saisaokh/cse453/IMG_20170519_164301.jpg

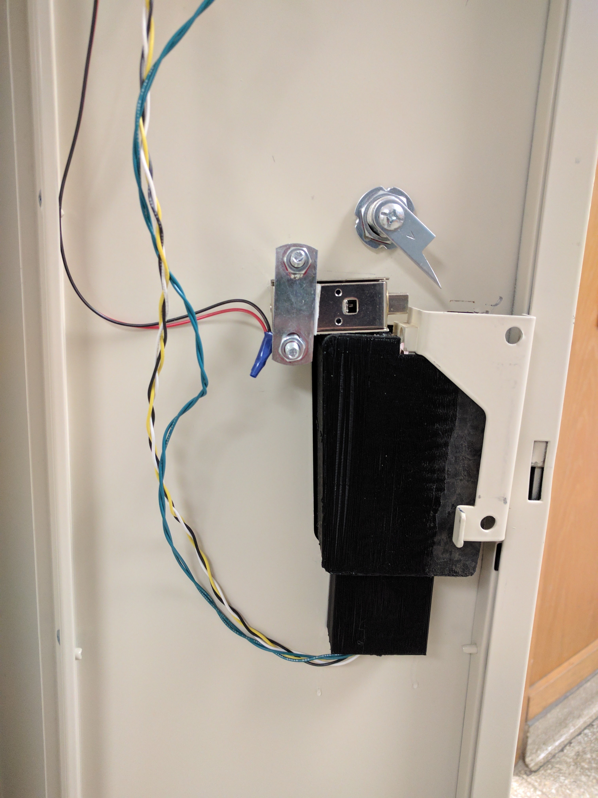
IMG_20170519_164301.jpg
