saisaokh/cse453/IMG_8142.JPG

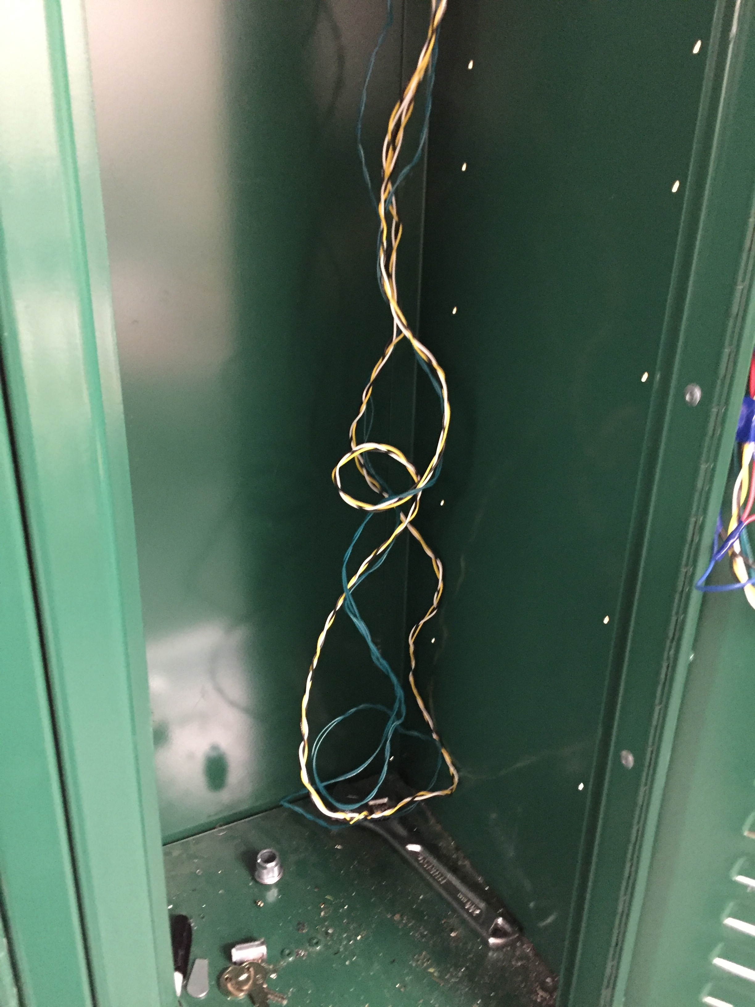
IMG_8142.JPG
