saisaokh/cse453/README.md

Final Presentation.pdf conclude overall.
