saisaokh/cse453/ProgressReport221-35.docx

Accomplished:

- Received the lockers and moved them into the baldy lab
- Placed order for most parts we will need for the project
- Discussed how we will modify the locker to use the solenoid that we ordered.

Upcoming:

- When parts come in we will finalize how the locking mechanism is going to work.
- Need to start testing the arduino with the screen for power consumption metrics.
- Test the solar panel to see how much power output it will offer us.
