saisaokh/cse453/FinalPresentation.pdf

‘-

1

Alden School District

# Automated Locker

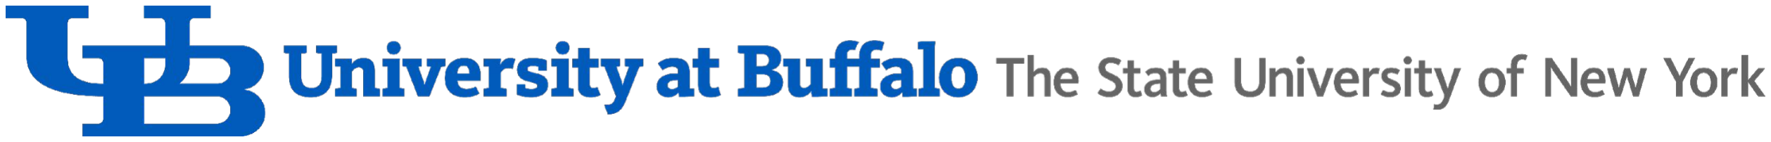
[picture p12: figure]

‘-

2

Mark Grassi
Sanjeevani Choudhery
John Fincken
Tristan Syre
Alex Kirschner
John McKissick
Sai Kham
Drew Clark

### Team Members

‘-

3

- Some students at Alden high school have difficulty opening lockers with a regular combination lock.
- The locks are too small and complicated for some students to use.
- The school wants an easier way for these students to open their lockers while still using a passcode.

### The Problem

‘-

4

### Approach

- Battery powered touch screen system to control solenoid lock
- Screen’s embedded microprocessor will be used to check user input and signal solenoid
- Custom 3-D printed case to mount screen in locker recess

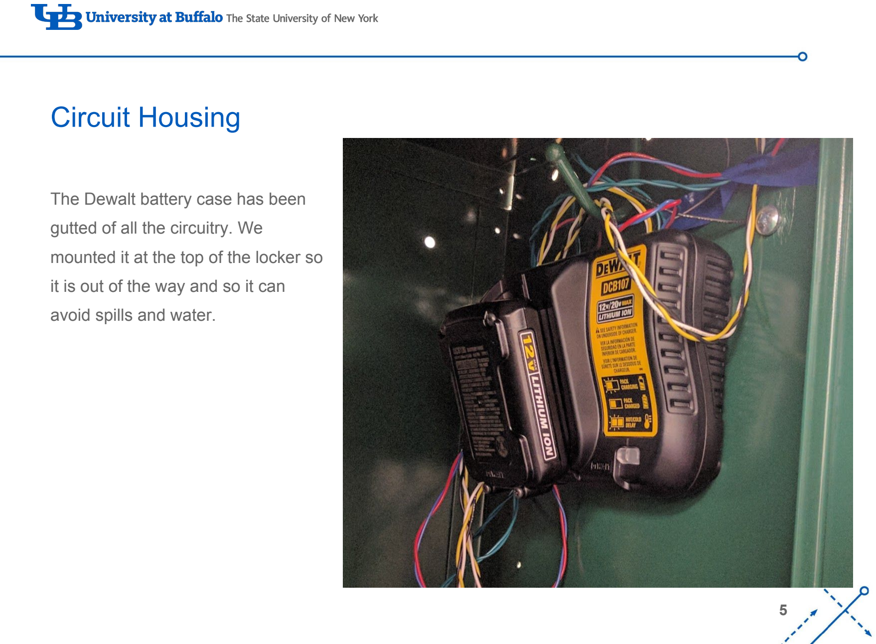
[picture p13: page 5]

‘-

5

The Dewalt battery case has been

gutted of all the circuitry. We

mounted it at the top of the locker so

it is out of the way and so it can

avoid spills and water.

### Circuit Housing

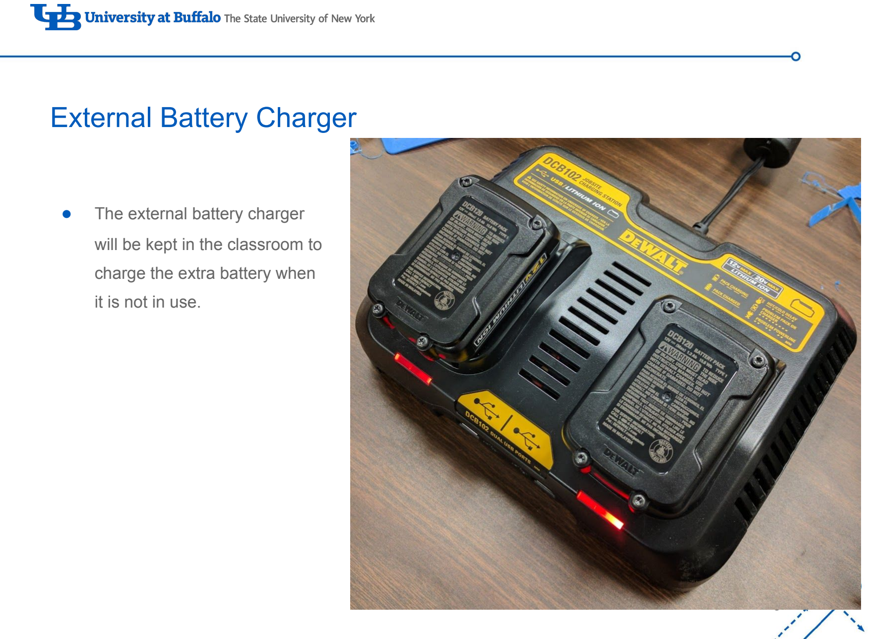
[picture p14: page 6]

‘-

6

- The external battery charger

will be kept in the classroom to

charge the extra battery when

it is not in use.

### External Battery Charger

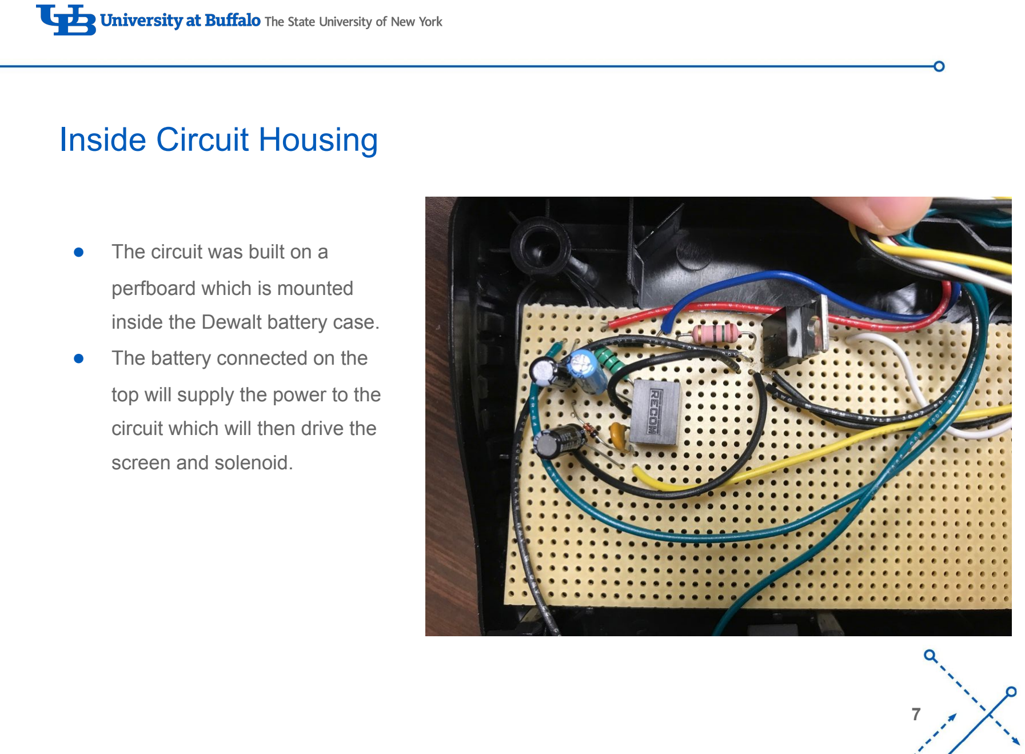
[picture p15: page 7]

‘-

7

- The circuit was built on a

perfboard which is mounted

inside the Dewalt battery case.

- The battery connected on the

top will supply the power to the

circuit which will then drive the

screen and solenoid.

### Inside Circuit Housing

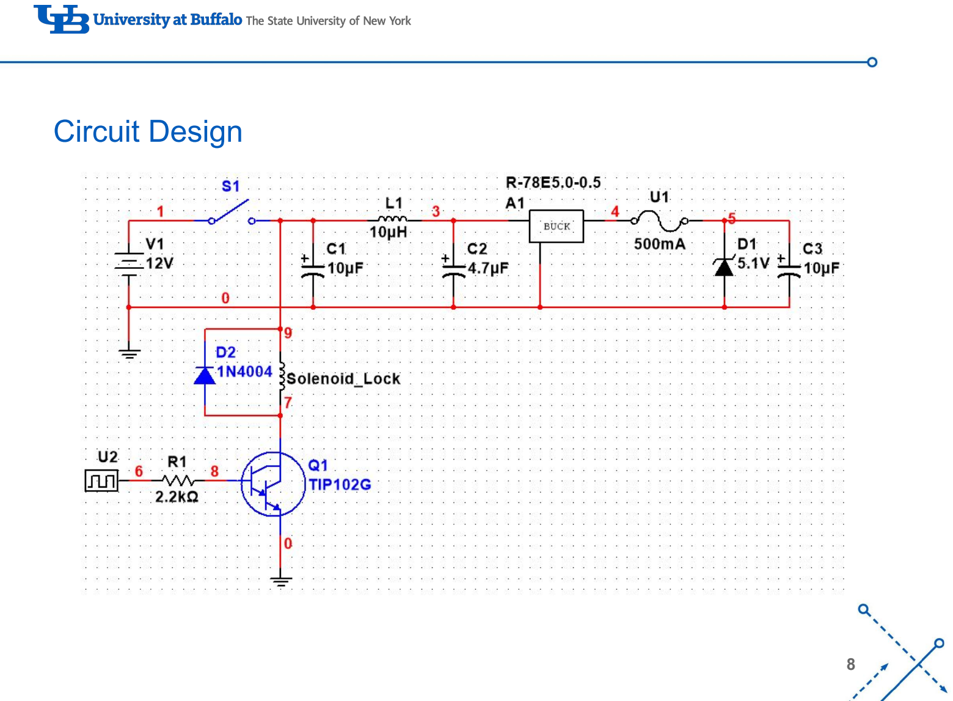
[picture p16: page 8]

‘-

8

### Circuit Design

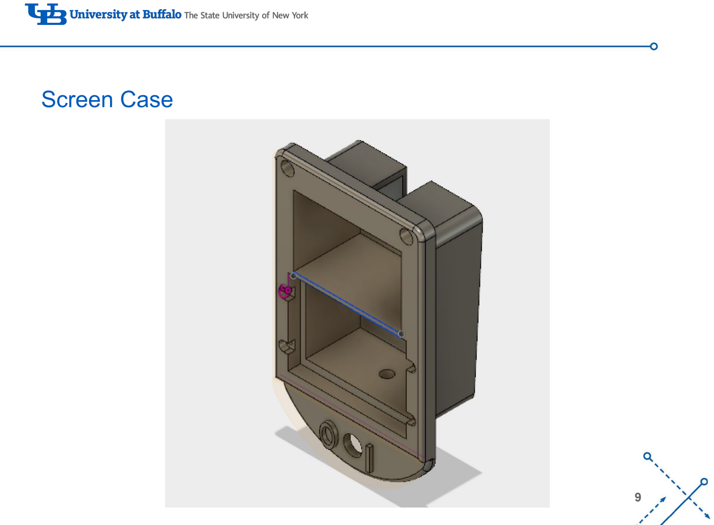
[picture p17: page 9]

‘-

9

### Screen Case

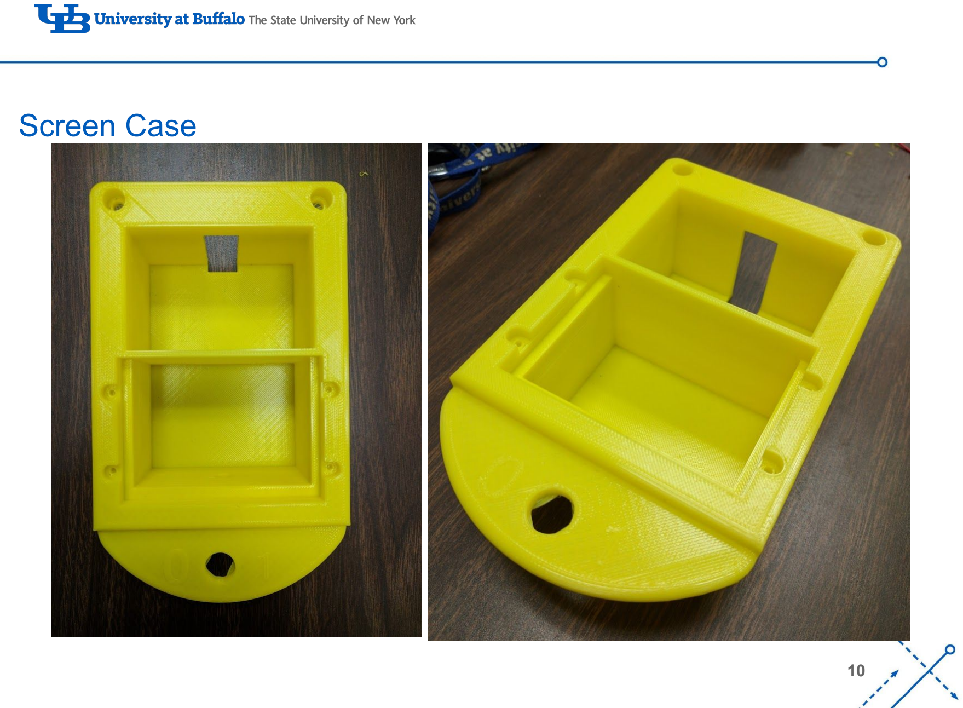
[picture p18: page 10]

‘-

10

### Screen Case

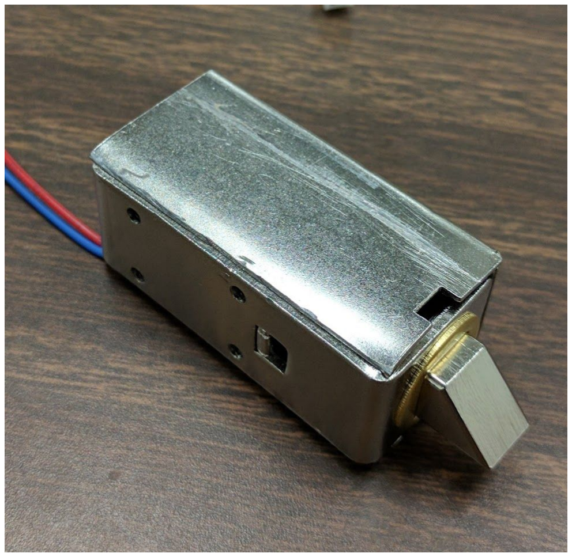
[picture p19: figure]

‘-

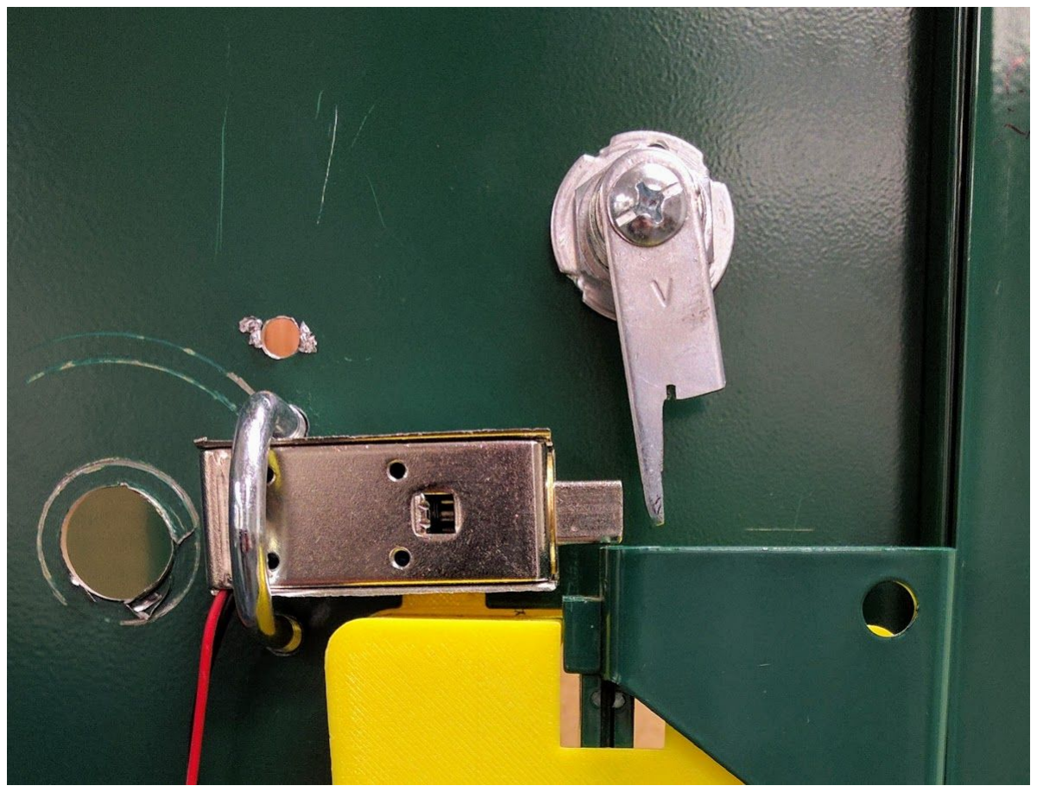
[picture p20: figure]

11

- The solenoid remains in the

locked position while no power is being supplied to it.
- When the user enters the

passcode the solenoid will open for 5 seconds allowing the user to lift the handle and open the locker.

### Solenoid

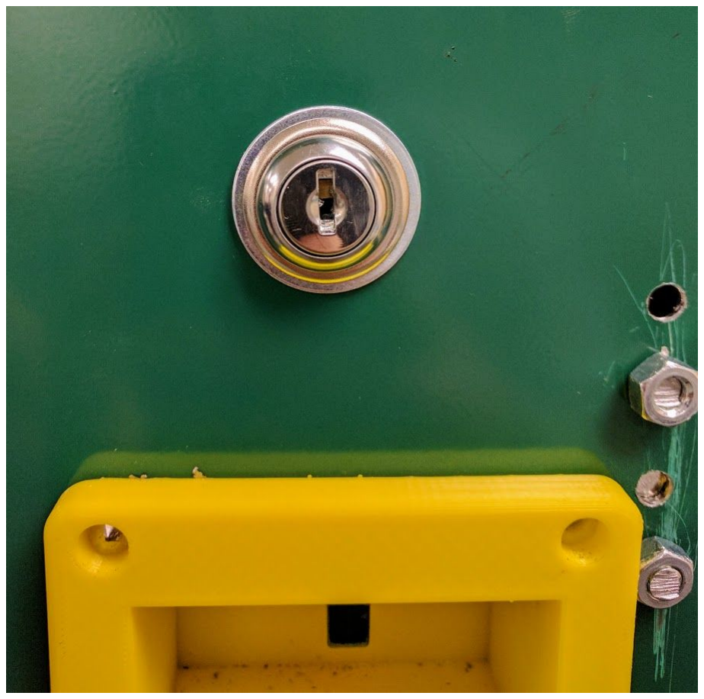
[picture p21: figure]

‘-

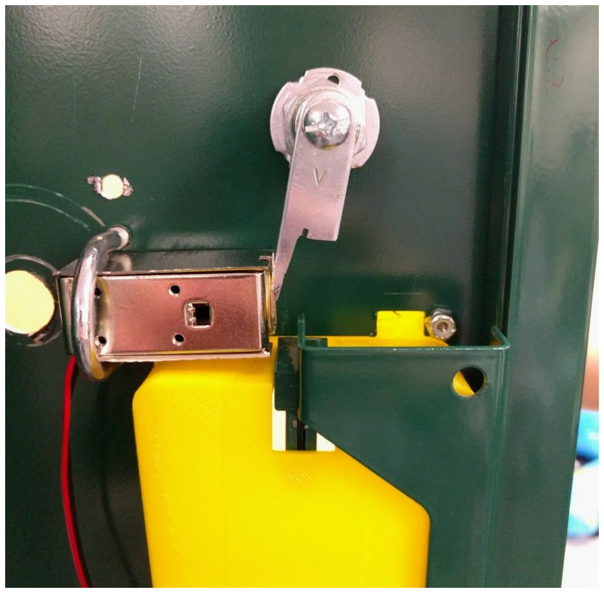
[picture p22: figure]

12

- The manual override is

used with a key we provide.
- A plate will push the

solenoid lock out of the way so the locker can be opened by faculty members or if the battery dies.

### Manual Override

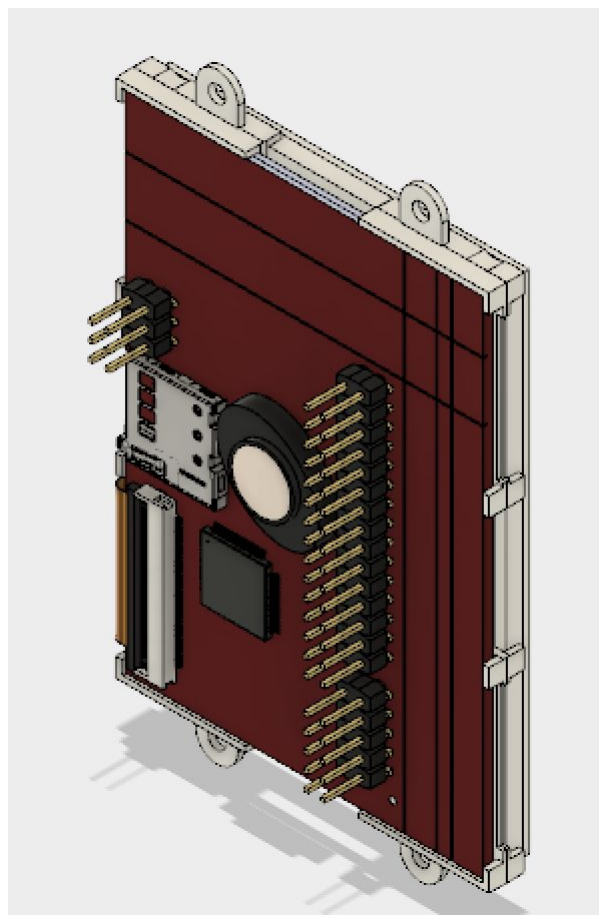
[picture p23: figure]
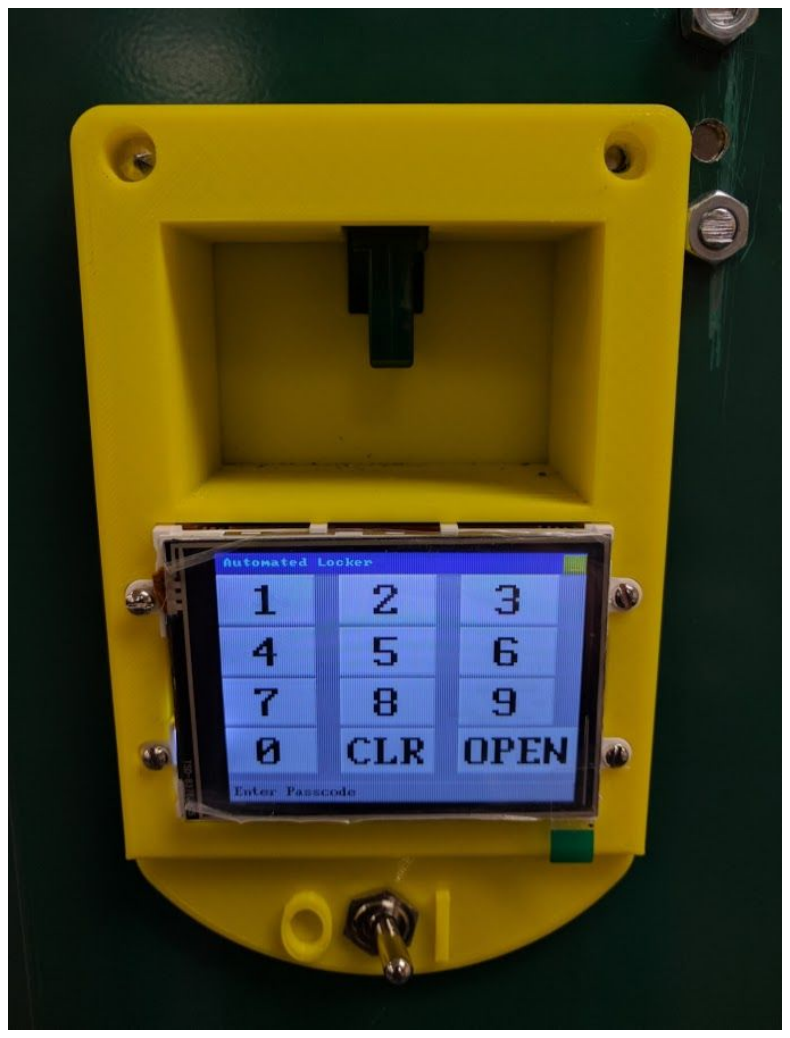
[picture p24: figure]

‘-

13

- Student User can

open
- Admin User can

reset password
- Powers off when not

in use

### Screen

14

### Locker Demo using the screen

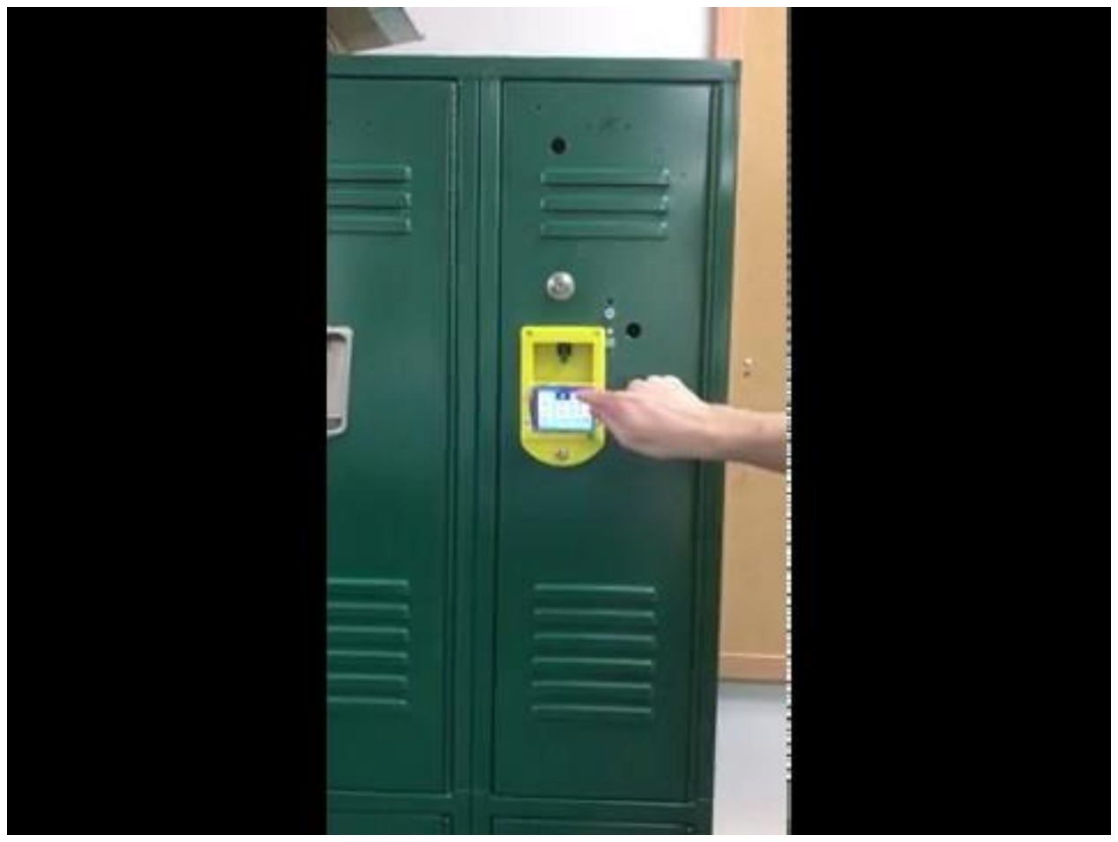
[picture p25: figure]

15

### Locker Demo with manual override

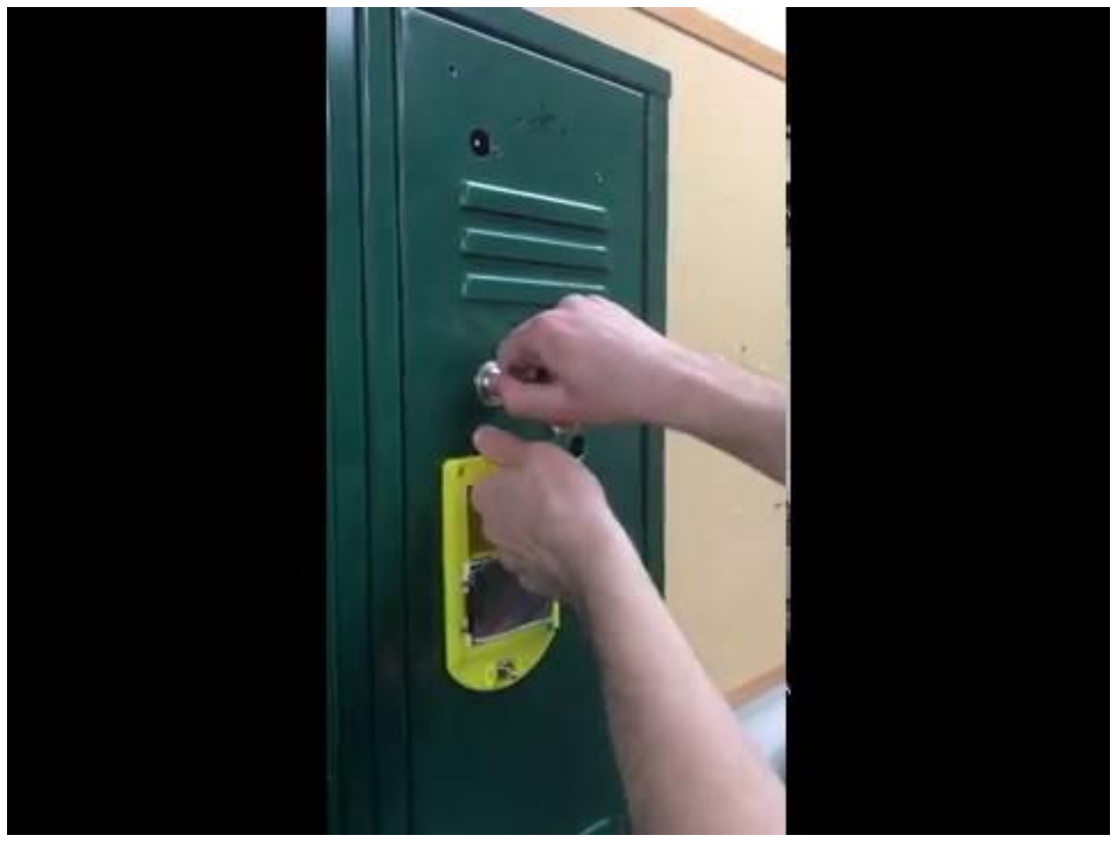
[picture p26: figure]
