saisaokh/cse453/IMG_8066.JPG

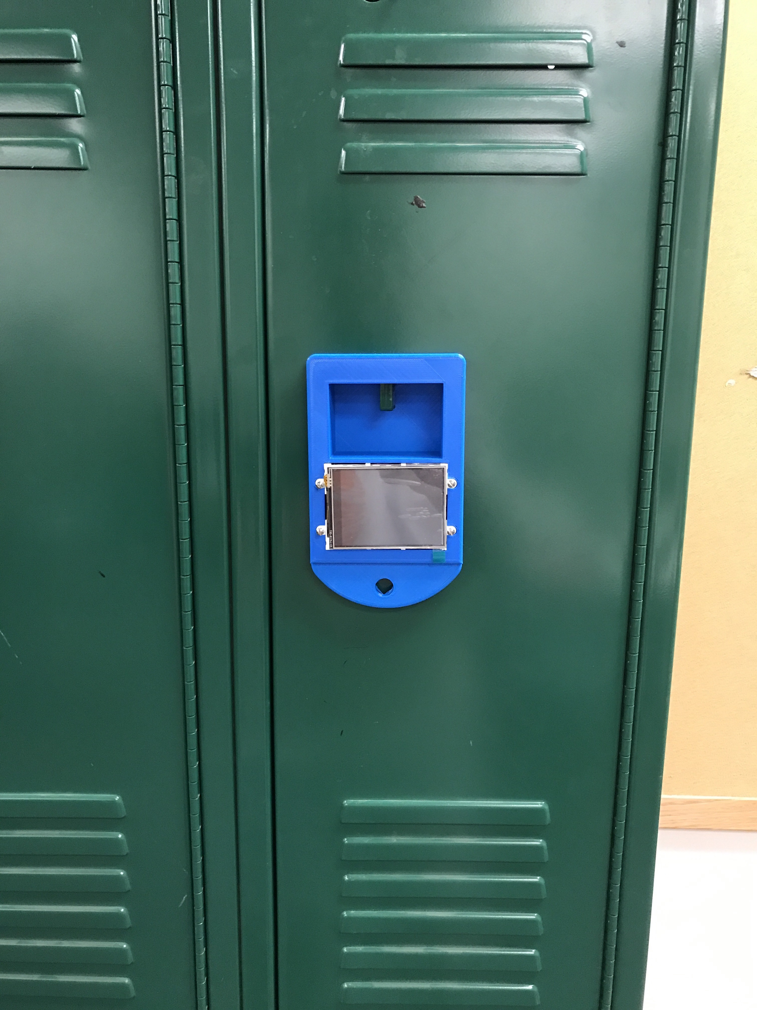
IMG_8066.JPG
