saisaokh/cse453/IMG_8068.JPG

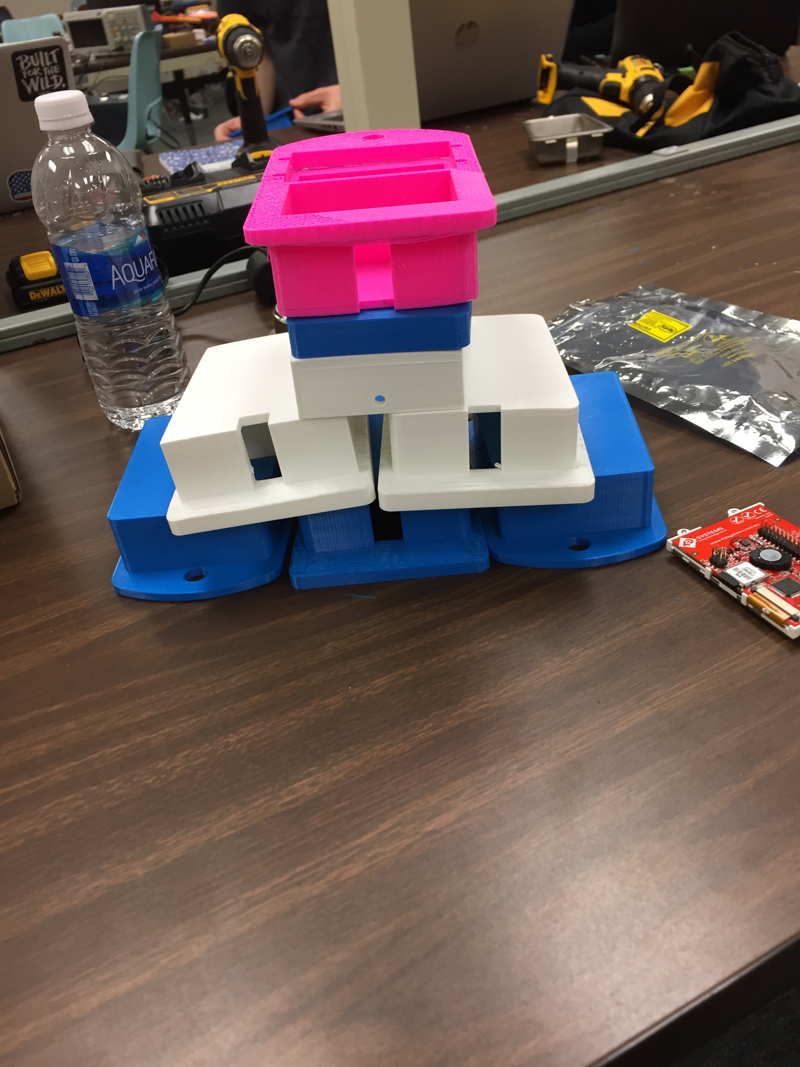
IMG_8068.JPG
