saisaokh/cse453/IMG_8139.JPG

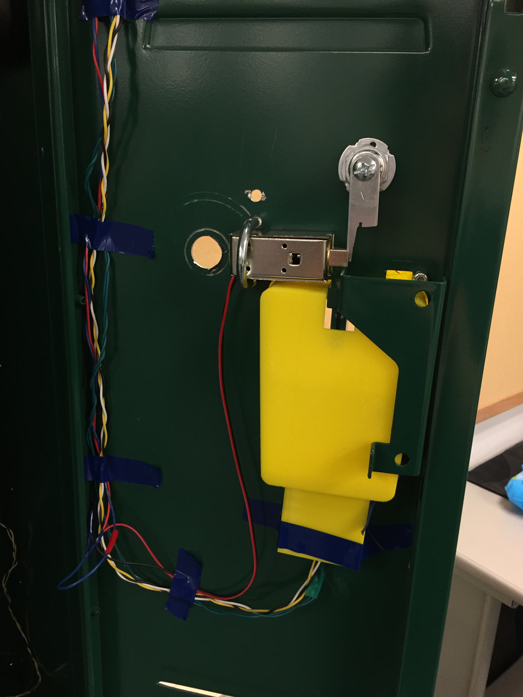
IMG_8139.JPG
