saisaokh/cse453/IMG_8140.JPG

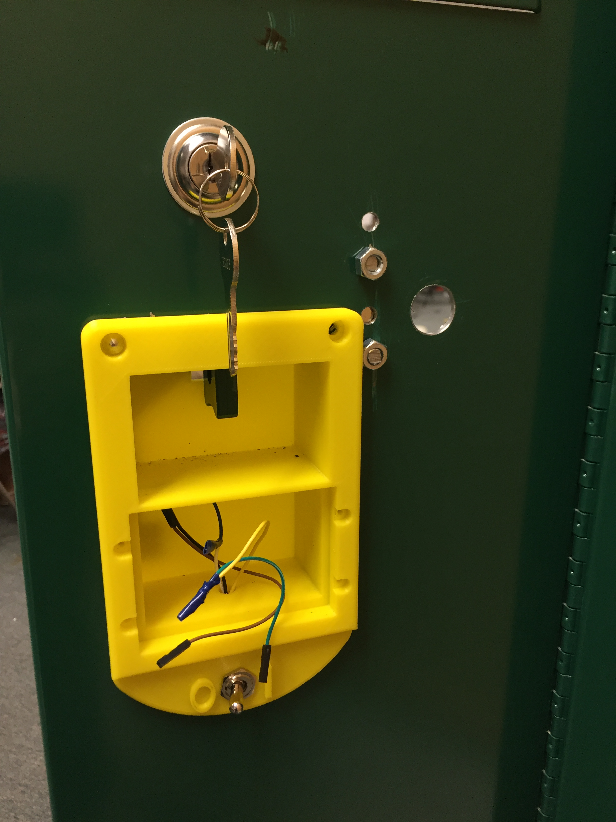
IMG_8140.JPG
