saisaokh/cse453/IMG_8141.JPG

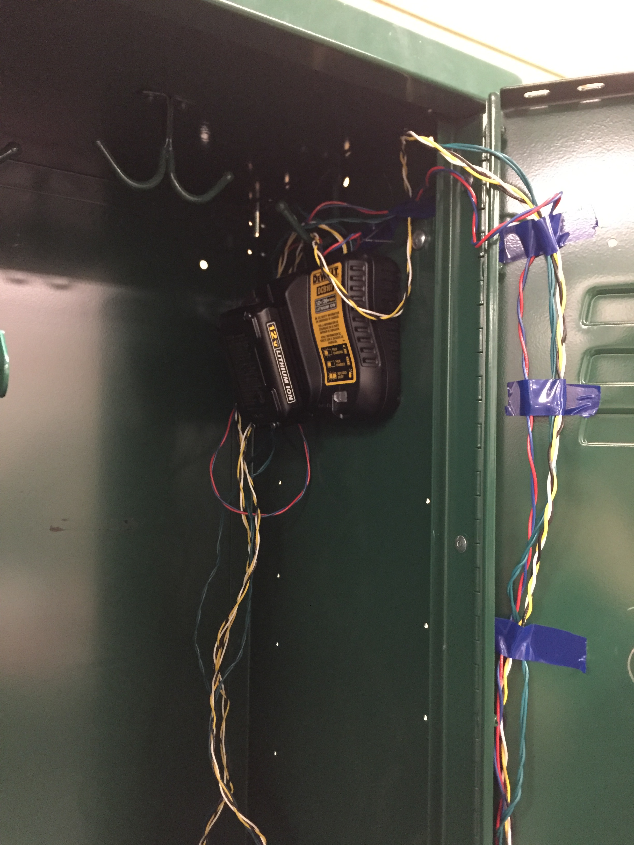
IMG_8141.JPG
