saisaokh/cse453/IMG_8166.PNG

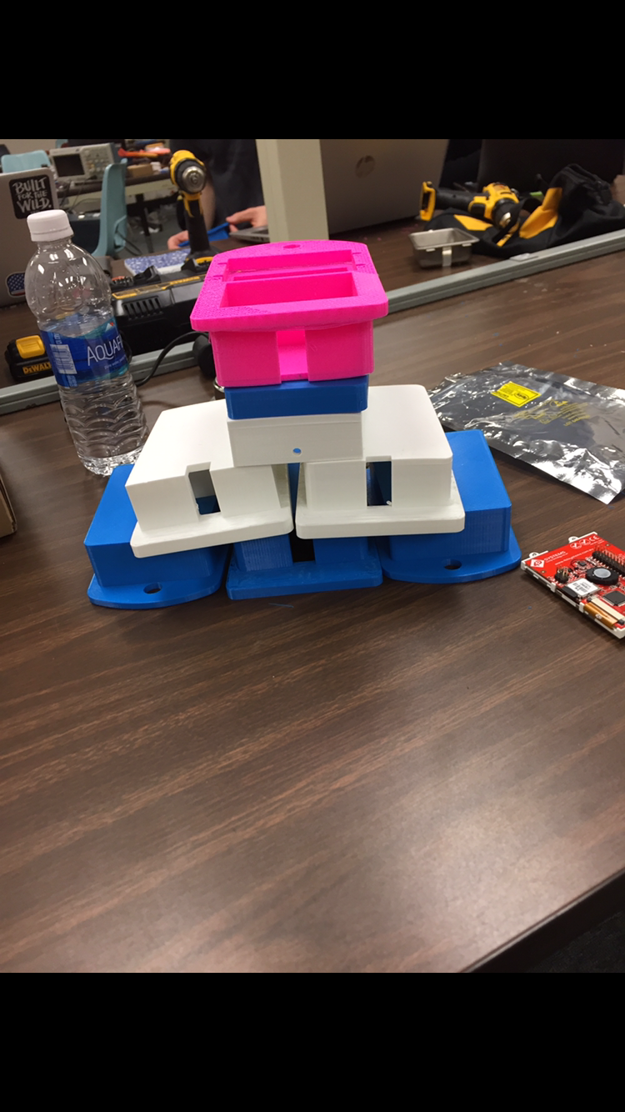
IMG_8166.PNG
