saisaokh/cse453/IMG_8168.JPG

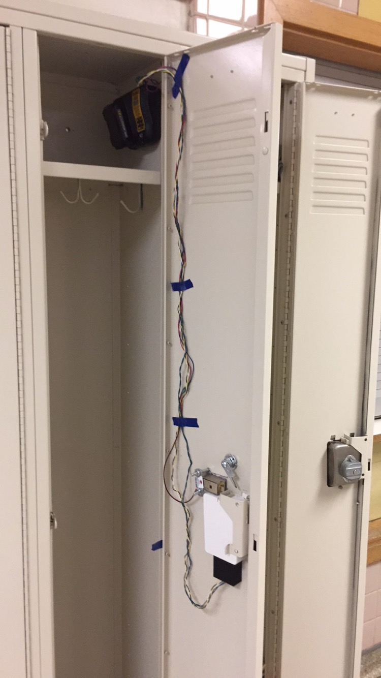
IMG_8168.JPG
