saisaokh/cse453/IMG_8169.JPG

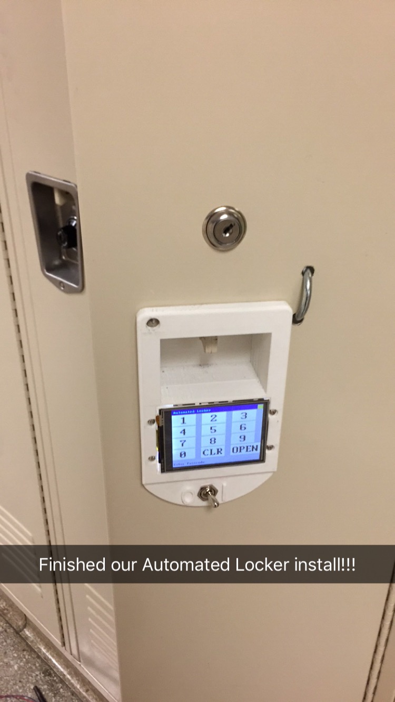
IMG_8169.JPG
