saisaokh/cse453/IMG_8170.JPG

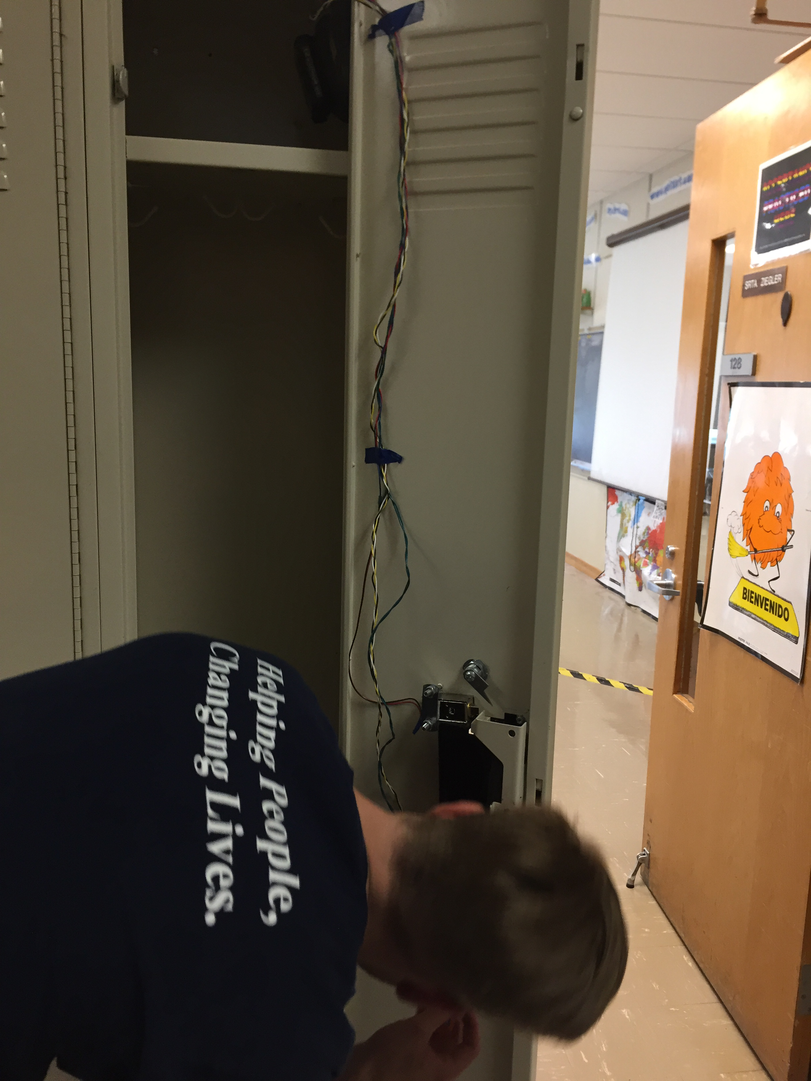
IMG_8170.JPG
