saisaokh/cse453/IMG_8171.JPG

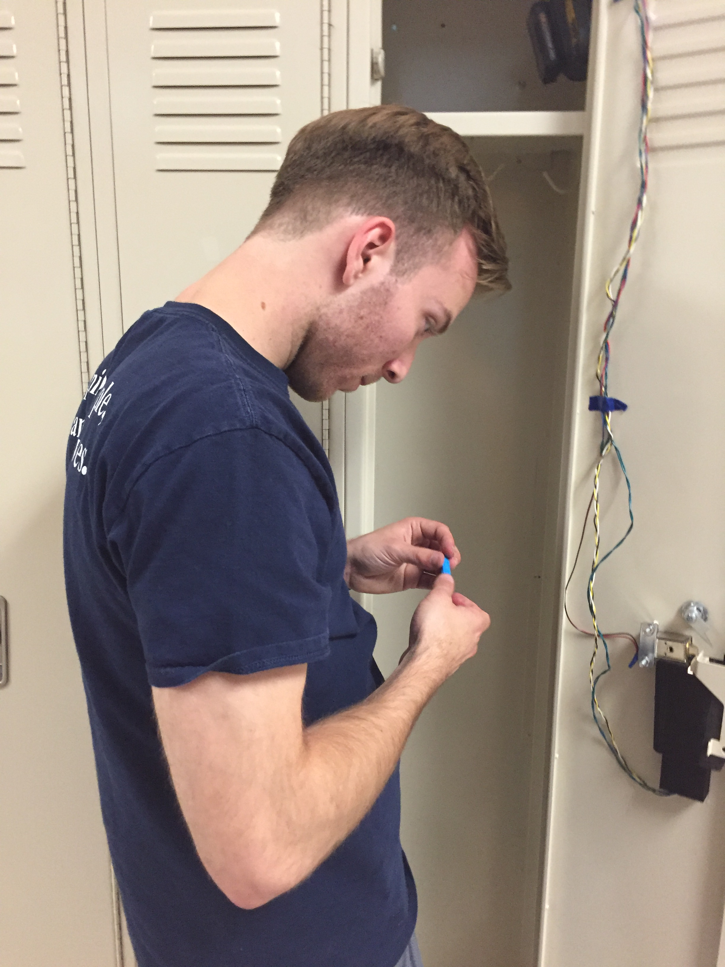
IMG_8171.JPG
