saisaokh/cse453/IMG_8172.JPG

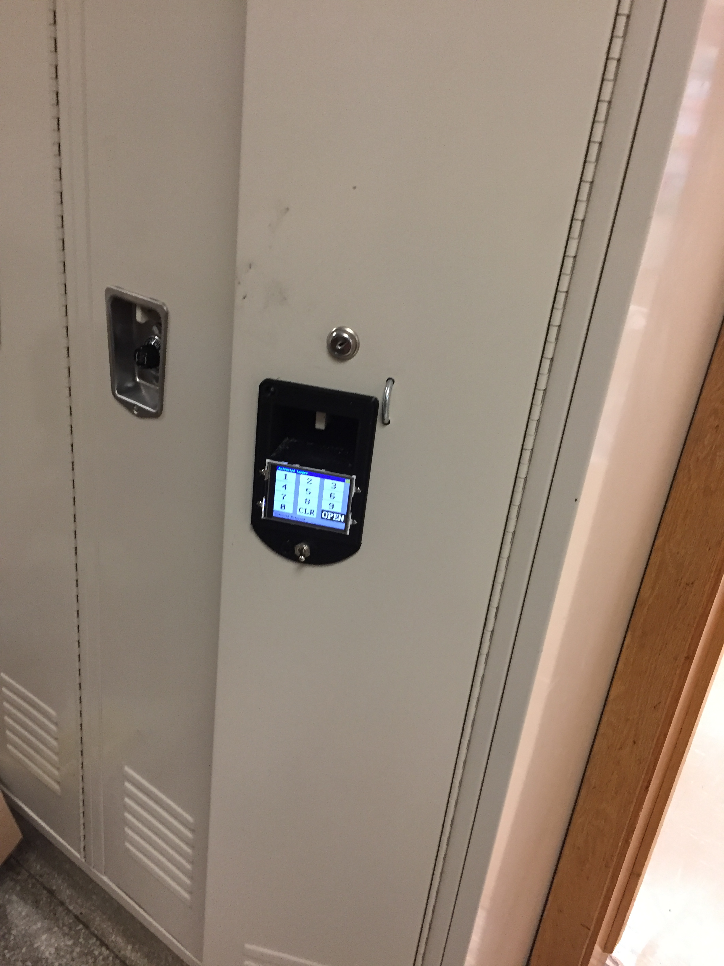
IMG_8172.JPG
