saisaokh/cse453/IMG_8173.JPG

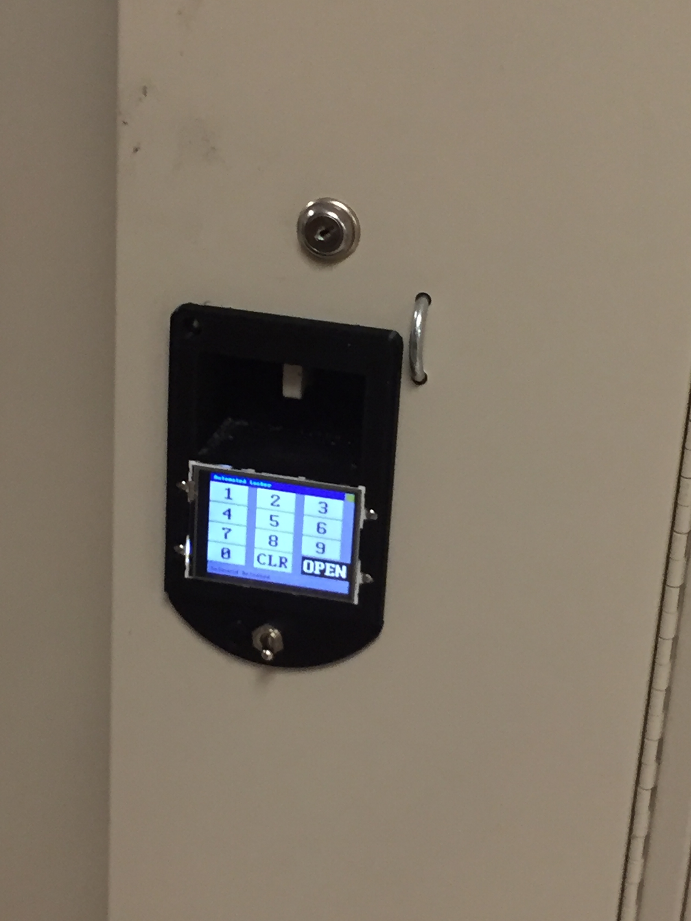
IMG_8173.JPG
