saisaokh/cse453/IMG_20170519_164307.jpg

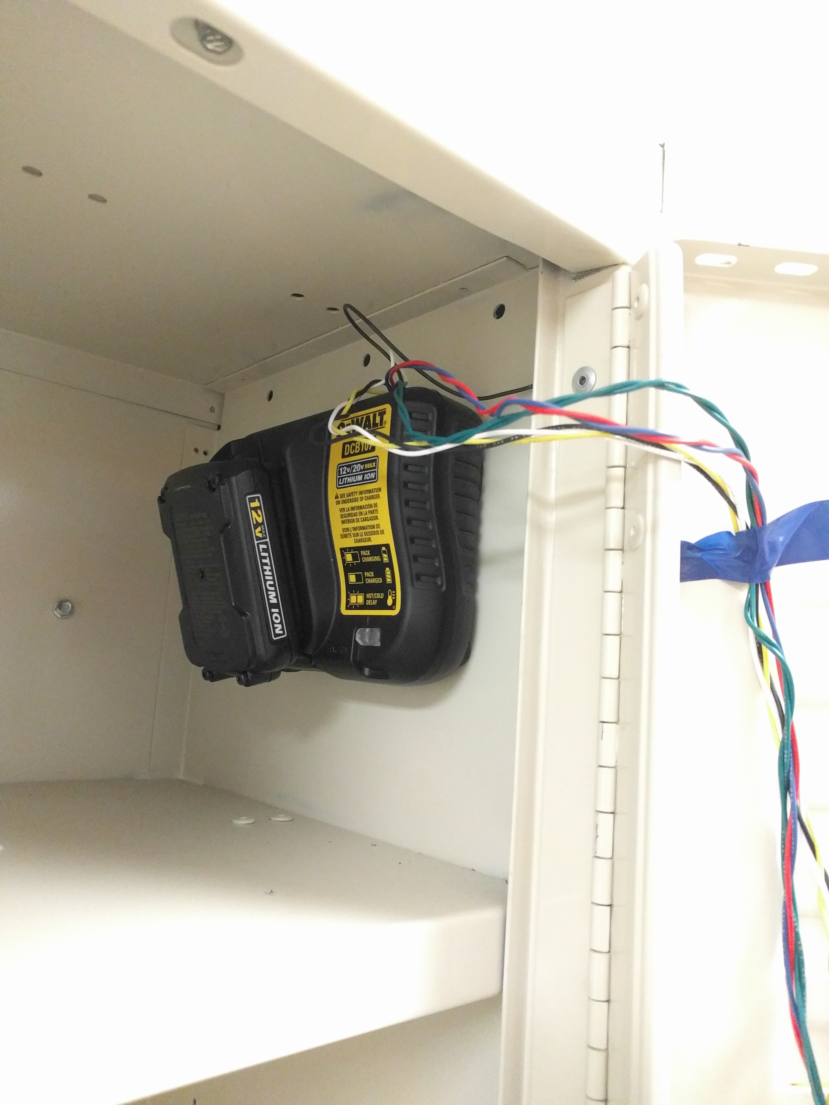
IMG_20170519_164307.jpg
