saisaokh/cse453/IMG_20170519_164314.jpg

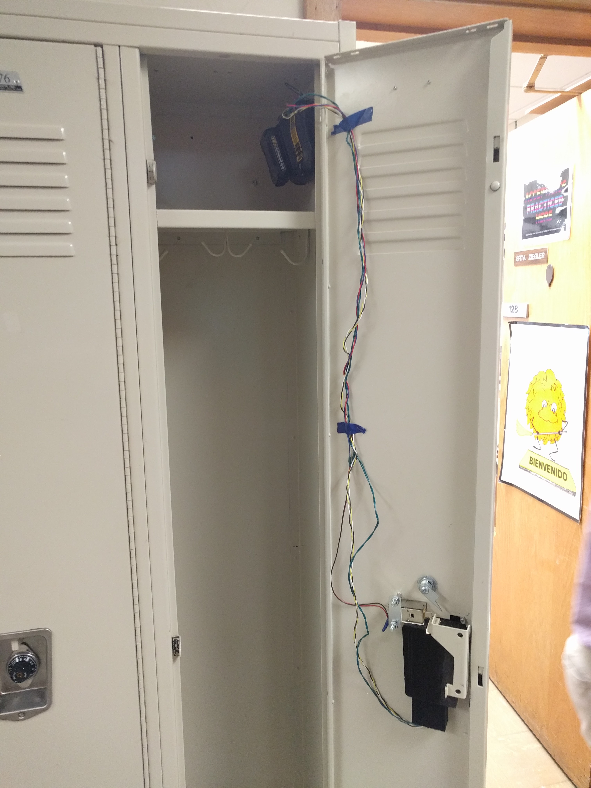
IMG_20170519_164314.jpg
