saisaokh/cse453/First Parts Order.pdf

Part Name | Vendor
Solar Panel | Sparkfun
Arduino Display | Sparkfun
Arduino Uno | Digi-Key
Lock-style Solenoid | Adafruit
1N4004 Diode | Digi-Key
TIP102 BJT | Digi-Key
TIP102-BP BJT | Digi-Key
Total

Link To Prod
https://www.sparkfun.com/products/13784https://www.sparkfun.com/products/11741http://www.digikey.com/product-detail/en/arduino/A000066/1050-1024-ND/2784006https://ww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

Ventor Part # | Manufacturer Part # | Unit Price | Quantity | Total Cost
PRT-13784 | | $89.00 | 1 | $89.00
LCD-11741 | ULCD-32PTU-AR | $84.95 | 1 | $84.95
1050-1024-ND | A000066 | $21.49 | 1 | $21.49
1512 | | $14.95 | 1 | $14.95
1N4004-TPMSCT-ND | 1N4004-TP | $0.10 | 10 | $0.99
TIP102GOS-ND | TIP102G | $0.83 | 5 | $4.15
TIP102-BP-ND | TIP102-BP | $1.23 | 5 | $6.15
| | | | $221.68
