saisaokh/cse453/Second Parts Order.pdf

Part Name | Vendor
Buck Converter | Digikey
10uF 50V Capacitor | Digikey
4.7uF 50V Capacitor | Digikey
10uH Inductor | Digikey
5V TVS Diode | Digikey
500mA Resettable Fuse | DigiKey
Perf Board | DigiKey
USB to TTL Serial Adapter | Digikey
SPST Toggle Switch | Digikey

Total

Link To Prod
https://www.digikey.com/product-detail/en/recom-power/R-78E5.0-0.5/945-1648-5-ND/2834904https://www.digikey.com/product-detail/en/nichicon/UKL1H100KDDANA/UKL1H100KDD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

https://www.digikey.com/product-detail/en/bourns-inc/77F100K-TR-RC/77F100K-TR-RCCT-ND/3741658https://www.digikey.com/product-detail/en/vishay-semiconductor-diodes-di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

Ventor Part # | Manufacturer Part # | Unit Price | Quantity | Total Cost
| | $2.84 | 4 | $11.36
| | $0.33 | 10 | $3.28
0 | $0.00 | Found In Lab
| | $0.24 | 4 | $0.96
| | $0.45 | 5 | $2.25
| | $0.26 | 5 | $1.29
| | $3.69 | 4 | $14.76
| | $20.00 | 1 | $20.00
| | $3.13 | 3 | $9.39
| | | | $63.29
