saisaokh/cse453/First Parts Order.xlsx

Part Name | Vendor | Link To Prod | Ventor Part # | Manufacturer Part # | Unit Price | Quantity | Total Cost
Solar Panel | Sparkfun | https://www.sparkfun.com/products/13784 | PRT-13784 |  | $89.00 | 1 | $89.00
Arduino Display | Sparkfun | https://www.sparkfun.com/products/11741 | LCD-11741 | ULCD-32PTU-AR | $84.95 | 1 | $84.95
Arduino Uno | Digi-Key | http://www.digikey.com/product-detail/en/arduino/A000066/1050-1024-ND/2784006 | 1050-1024-ND | A000066 | $21.49 | 1 | $21.49
Lock-style Solenoid | Adafruit | https://www.adafruit.com/product/1512 | 1512 |  | $14.95 | 1 | $14.95
1N4004 Diode | Digi-Key | http://www.digikey.com/product-detail/en/micro-commercial-co/1N4004-TP/1N4004-TPMSCT-ND/773691 | 1N4004-TPMSCT-ND | 1N4004-TP | $0.10 | 10 | $0.99
TIP102 BJT | Digi-Key | http://www.digikey.com/product-detail/en/on-semiconductor/TIP102G/TIP102GOS-ND/920319 | TIP102GOS-ND | TIP102G | $0.83 | 5 | $4.15
TIP102-BP BJT | Digi-Key | http://www.digikey.com/product-detail/en/micro-commercial-co/TIP102-BP/TIP102-BP-ND/1306188 | TIP102-BP-ND | TIP102-BP | $1.23 | 5 | $6.15
Total |  |  |  |  |  |  | $221.68
