saisaokh/cse453/Second Parts Order.xlsx

Part Name | Vendor | Link To Prod | Ventor Part # | Manufacturer Part # | Unit Price | Quantity | Total Cost
Buck Converter | Digikey | https://www.digikey.com/product-detail/en/recom-power/R-78E5.0-0.5/945-1648-5-ND/2834904 |  |  | $2.84 | 4 | $11.36
10uF 50V Capacitor | Digikey | https://www.digikey.com/product-detail/en/nichicon/UKL1H100KDDANA/UKL1H100KDDANA-ND/2428102 |  |  | $0.33 | 10 | $3.28
4.7uF 50V Capacitor | Digikey |  |  |  |  | 0 | $0.00 | Found In Lab
10uH Inductor | Digikey | https://www.digikey.com/product-detail/en/bourns-inc/77F100K-TR-RC/77F100K-TR-RCCT-ND/3741658 |  |  | $0.24 | 4 | $0.96
5V TVS Diode | Digikey | https://www.digikey.com/product-detail/en/vishay-semiconductor-diodes-division/SA5.0A-E3-54/SA5.0A-E3-54GICT-ND/2880343 |  |  | $0.45 | 5 | $2.25
500mA Resettable Fuse | DigiKey | https://www.digikey.com/product-detail/en/bourns-inc/MF-R030-2/MF-R030-2CT-ND/3438019 |  |  | $0.26 | 5 | $1.29
Perf Board | DigiKey | https://www.digikey.com/product-detail/en/keystone-electronics/3399/36-3399-ND/315991 |  |  | $3.69 | 4 | $14.76
USB to TTL Serial Adapter | Digikey | https://www.digikey.com/product-detail/en/4d-systems-pty-ltd/UUSB-PA5-II/1613-1118-ND/5725506 |  |  | $20.00 | 1 | $20.00
SPST Toggle Switch | Digikey | https://www.digikey.com/product-detail/en/electroswitch/7105D/451-1158-ND/2679541 |  |  | $3.13 | 3 | $9.39
Total |  |  |  |  |  |  | $63.29
