saisaokh/cse453/trueLockFinal.stl

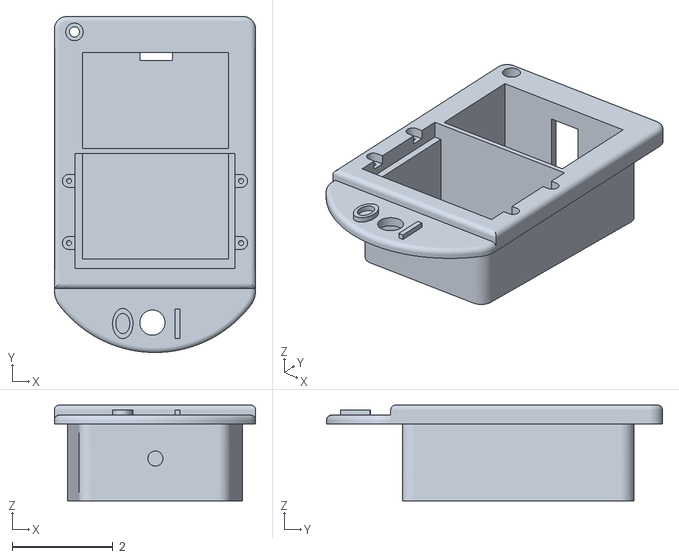
[picture p41: CAD file, 2017-07-12]
trueLockFinal.stl
4.00 x 6.68 x 1.91
