saisaokh/cse453/(list of files, drawings)

Other design files:
Locker Circuit.ms13
