saisaokh/cse453/(commit log)

2017-04-20 makerbot replicator 2
    used 3D printer and printed on April 18 for locker case
2017-07-12 added on 7/12/2017
    include: circuit, user manual, progress report, tech doc, final presentation, trueLockFinal.stl, etc
    [Locker Circuit.ms13, trueLockFinal.stl]
2017-07-12 cse453 summary
    require docs uploaded
    [First Parts Order.xlsx, Second Parts Order.xlsx]
